e-jigsaw/eurorack/ember/primitives/jacks/pj301m-12.md

# PJ301M-12 (Thonkiconn)

Eurorack で de facto 標準の 3.5mm vertical mono switching jack。Mutable Instruments を含むほぼ全モジュールで採用。

## ピン

| Pin | Label / aliases | 役割 | X | Y |
|---|---|---|---:|---:|
| 1 | `TIP` | プラグ挿入時の信号 | 0 | −4.92 |
| 2 | `NORM_TIP` / `SWITCH` | プラグ未挿入時に TIP に内部結線される (normalled) | 0 | +3.38 |
| 3 | `SLEEVE` / `GND` | リターン | 0 | +6.48 |

座標は barrel 中心を原点、mm。

## フットプリント

- pad: Ø1.8 mm 円、drill: Ø1.6 mm (nebs/eurocad など de facto 慣用値)
- barrel 直下に Ø3 mm NPTH (datasheet 推奨)
- 本体 outline: 9.0 × 9.0 mm

## 機械仕様 (CMS-263 確定)

| 項目 | 値 |
|---|---|
| board-to-panel | 10.0 mm |
| bushing ねじ部 (= パネル板厚許容) | 4.5 mm |
| bushing ねじ | M6 × 0.75 |
| パネル穴推奨 | Ø6.3 mm (Mutable Links 実測) |

## 対応シンボル名

| CAD | 名称 |
|---|---|
| Mutable Instruments Eagle | `PJ301_THONKICONN6` |
| KiCad (標準ライブラリ近似) | `Connector_Audio:Jack_3.5mm_QingPu_WQP518WB-G_Vertical` |

## 出典

- Thonk datasheet: https://www.thonk.co.uk/wp-content/uploads/2014/02/Thonkiconn_Jack_Datasheet.pdf
- Thonk 商品ページ: https://www.thonk.co.uk/shop/thonkiconn/
- nebs/eurocad KiCad: https://github.com/nebs/eurocad/blob/master/Eurocad.pretty/PJ301M-12.kicad_mod
- Qingpu (元メーカー): http://qingpu-electronics.com/en/products/WQP-PJ301M-12-306.html
- firstpr.com.au 実測: https://www.firstpr.com.au/rwi/parts/3.5mm-sockets/

## 関連 Linear

- CMS-259 (この実装)
- CMS-263 (軸長検証、Done)
