e-jigsaw/eurorack/ember/__snapshots__/links-control.circuit-3d.snap.png

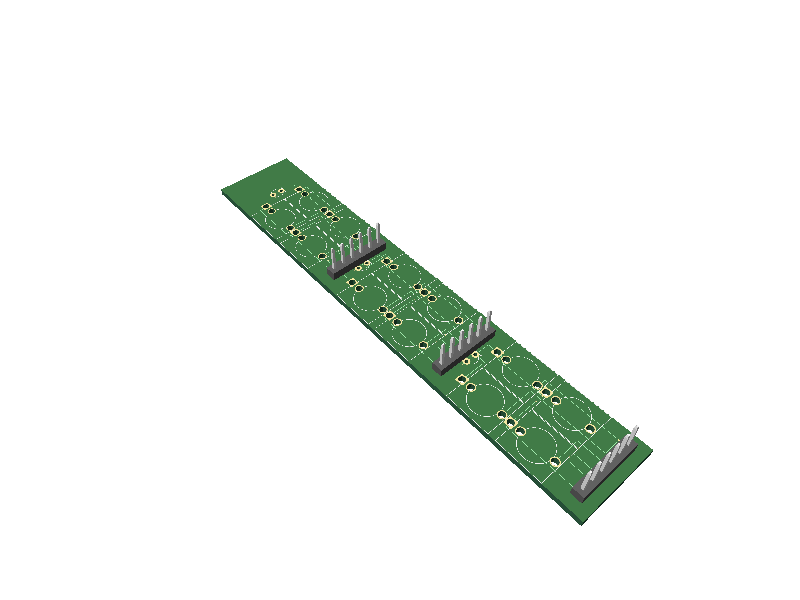
ember/__snapshots__/links-control.circuit-3d.snap.png
