e-jigsaw/eurorack/links/hardware_design/pcb/links_v40.9.brd

## EAGLE design links/hardware_design/pcb/links_v40.9.brd (2026-05-17)

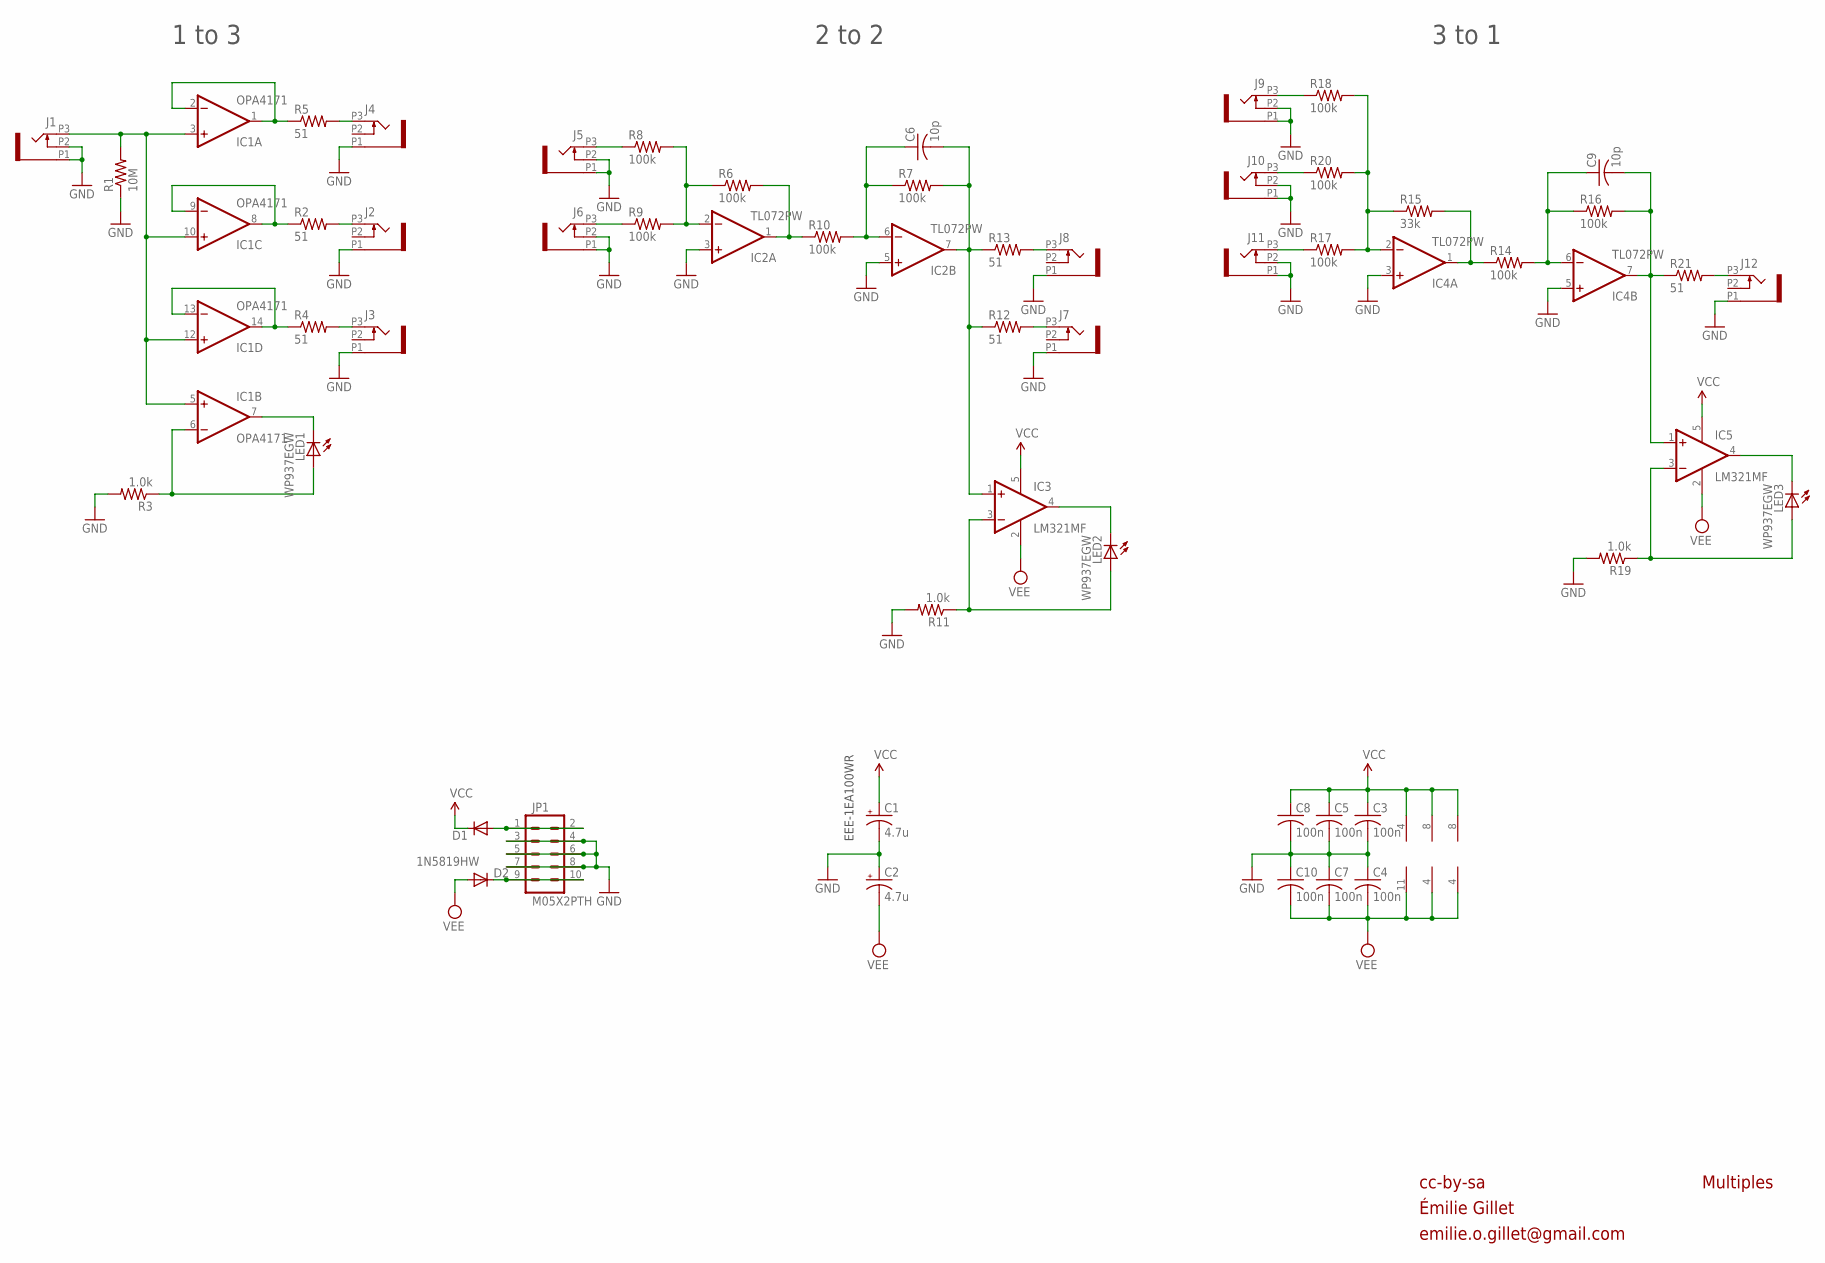
[picture p2: schematic links_v40.9.sch]

Parts:
C1, C2: 4.7u; PANASONIC_A
C3, C4, C5, C7, C8, C10: 100n; C0603
C6, C9: 10p; C0603
D1, D2: 1N5819HW; SOD123
IC1: OPA4171; TSSOP14
IC2, IC4: TL072PW; TSSOP8
IC3, IC5: LM321MF; SOT23-5
J1, J2, J3, J4, J5, J6, J7, J8, J9, J10, J11, J12: PJ301_THONKICONN6; WQP_PJ_301M6
JP1: M05X2PTH; AVR_ICSP
LED1, LED2, LED3: WP937EGW; LED3MM
R1: 10M; R0603
R2, R4, R5, R12, R13, R21: 51; R0603
R3, R11, R19: 1.0k; R0603
R6, R7, R8, R9, R10, R14, R16, R17, R18, R20: 100k; R0603
R15: 33k; R0603

Connections:
GND: C1.-, C2.+, C3.2, C4.1, C5.2, C7.1, C8.2, C10.1, IC2.3 (+IN), IC2.5 (+IN), IC4.3 (+IN), IC4.5 (+IN), J1.P1 (1), J1.P2 (2), J2.P1 (1), J3.P1 (1), J4.P1 (1), J5.P1 (1), J5.P2 (2), J6.P1 (1), J6.P2 (2), J7.P1 (1), J8.P1 (1), J9.P1 (1), J9.P2 (2), J10.P1 (1), J10.P2 (2), J11.P1 (1), J11.P2 (2), J12.P1 (1), JP1.3, JP1.4, JP1.5, JP1.6, JP1.7, JP1.8, R1.1, R3.2, R11.2, R19.2
unnamed: IC2.1 (OUT), R6.2, R10.1
unnamed: J11.P3 (3), R17.1
unnamed: IC1.1 (OUT), IC1.2 (-IN), R5.1
unnamed: IC1.8 (OUT), IC1.9 (-IN), R2.1
unnamed: IC1.13 (-IN), IC1.14 (OUT), R4.1
unnamed: D1.A, JP1.1, JP1.2
unnamed: IC1.3 (+IN), IC1.5 (+IN), IC1.10 (+IN), IC1.12 (+IN), J1.P3 (3), R1.2
unnamed: IC1.7 (OUT), LED1.K (C)
unnamed: J10.P3 (3), R20.1
unnamed: J6.P3 (3), R9.1
unnamed: J4.P3 (3), R5.2
unnamed: J2.P3 (3), R2.2
unnamed: J3.P3 (3), R4.2
unnamed: IC3.4 (OUT), LED2.K (C)
unnamed: J5.P3 (3), R8.1
unnamed: J7.P3 (3), R12.2
unnamed: J8.P3 (3), R13.2
unnamed: C9.2, IC4.7 (OUT), IC5.1 (+IN), R16.2, R21.1
unnamed: IC5.3 (-IN), LED3.A, R19.1
unnamed: D2.C, JP1.9, JP1.10
unnamed: IC1.6 (-IN), LED1.A, R3.1
unnamed: J9.P3 (3), R18.1
unnamed: J12.P3 (3), R21.2
unnamed: IC4.2 (-IN), R15.1, R17.2, R18.2, R20.2
unnamed: IC4.1 (OUT), R14.1, R15.2
unnamed: C6.2, IC2.7 (OUT), IC3.1 (+IN), R7.2, R12.1, R13.1
unnamed: C9.1, IC4.6 (-IN), R14.2, R16.1
unnamed: IC3.3 (-IN), LED2.A, R11.1
unnamed: IC5.4 (OUT), LED3.K (C)
unnamed: IC2.2 (-IN), R6.1, R8.2, R9.2
unnamed: C6.1, IC2.6 (-IN), R7.1, R10.2
VCC: C1.+, C3.1, C5.1, C8.1, D1.C, IC1.4 (V+), IC2.8 (V+), IC3.5 (V+), IC4.8 (V+), IC5.5 (V+)
VEE: C2.-, C4.2, C7.2, C10.2, D2.A, IC1.11 (V-), IC2.4 (V-), IC3.2 (V-), IC4.4 (V-), IC5.2 (V-)

Notes on the sheet:
cc-by-sa
Multiples
1 to 3
2 to 2
3 to 1
EEE-1EA100WR
Émilie Gillet
emilie.o.gillet@gmail.com

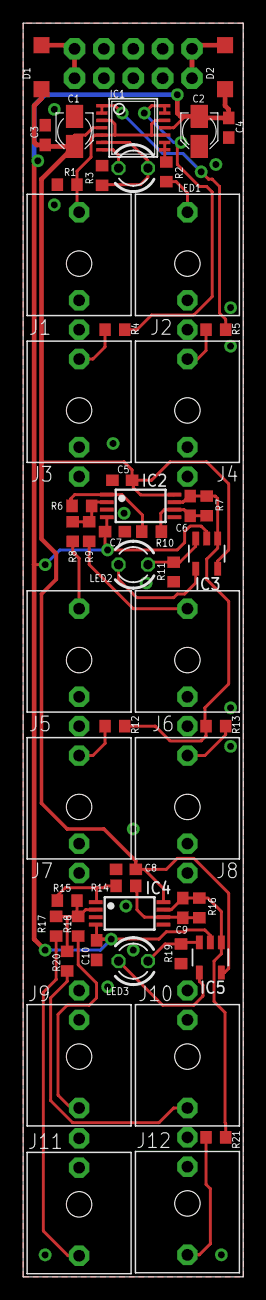
[picture p3: board links_v40.9.brd from above]

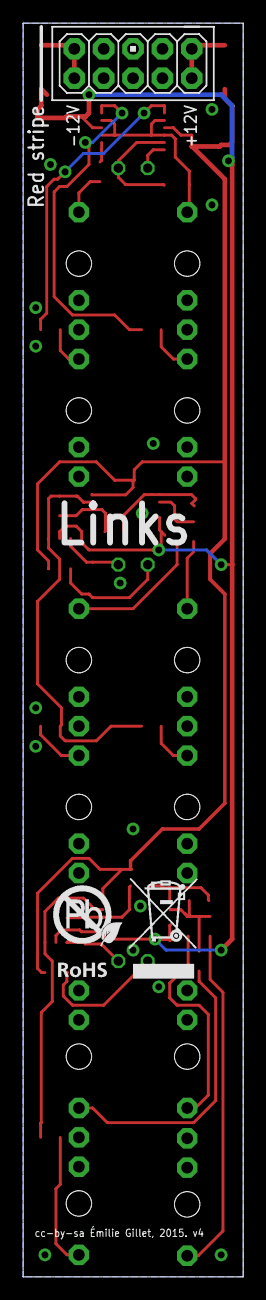
[picture p4: board links_v40.9.brd from below]

Board: 2 copper layers, 19.0 x 108.4 mm, 55 parts (2 on the bottom side), 34 nets.

Other parts of the board:
U$2: ROHS
