e-jigsaw/eurorack/(commit log)

2026-04-14 Added Eagle to KiCad migration investigation notes
2026-05-17 Archived Eagle to KiCad migration investigation and parser
    Stopped pursuing the Eagle-to-KiCad routes (Autodesk-based conversion
    and PDF reconstruction) in favor of evaluating the Autodesk MCP
    integration. Moved the migration notes and the eagle_parser tooling
    under archive/ for reference.
2026-05-17 Links: JLCPCB assembly BOM substitution and Eagle v40.9 reformat
    Picked LCSC-stocked alternatives for parts unavailable on JLCPCB and
    documented the rationale alongside an Eagle script that swaps the
    ATTRIBUTE/VALUE fields. Re-saved the Eagle files as v40.9 in the
    newer format so Autodesk Fusion's KiCad import path becomes usable.
    [links_v40.9.brd, links_v40.9.sch]
2026-05-17 Added ember tscircuit project with PJ301M-12 primitive
    Bootstrapped a tscircuit project under ember/ to incrementally
    re-implement Mutable Instruments modules. First reusable primitive
    is the PJ301M-12 (Thonkiconn) 3.5mm vertical jack footprint,
    verified via tsci build and snapshot.
2026-05-17 ember: Eurorack power input (Doepfer header + reverse protection)
    Adds the Doepfer 2x5 box header pinout/footprint (67996-410HLF), plus
    an EurorackPowerInput subcircuit wrapping Mutable's standard
    series-Schottky reverse protection (1N5819HW x 2) with 47uF/25V bulk
    caps. Verified via tsci build and snapshot.
2026-05-17 ember: EurorackPCB primitive (minimal board wrapper)
    Adds the EurorackPCB component as a thin <board> wrapper:
    auto-sized from children (PCB is sized to fit placed parts),
    1.6mm default thickness, no mounting holes (the PCB is secured
    to the front panel via the jack bushing nuts, following the
    Mutable/Eurorack convention). Also exports HP_MM (5.08, nominal
    HP) and PANEL_MM_PER_HP (5.0, Doepfer panel convention).
2026-05-17 ember: drop reverse-polarity protection from EurorackPowerInput
    Doepfer box header notch + keyed IDC ribbon (Tiptop / Make Noise /
    Erica / Doepfer 純正 etc.) physically prevent reverse insertion, so
    the series Schottky diodes are redundant. Aligns with MiniOSC v2.1
    and the DIY convention. Bulk caps reduced to 22uF/25V 0805 for
    realistic X7R capacity, and the decoupling pattern (one 100nF per
    IC rail via <capacitor decouplingFor>) is documented in the README.
2026-05-17 ember: Links module v1 (BM/US/SM + IC rotation + jack silk on bottom)
    Adds the Links module composition (1→3 BufferedMult, 2:2 UtilitySum,
    3→1 SumMixer3to1) plus chip primitives (OPA4171, TL072, LM321) and
    WP937EGW LED. ICs are vertical (pcbRotation=90) to fit the 4HP width;
    component positions iterated via dev UI manual edits. Jack silkscreen
    is now on the bottom layer so it doesn't compete with the panel face.
    Captured at a checkpoint before stripping component positions to let
    the autorouter retry placement.
2026-05-20 ember: Links blocks decomposed into reusable units with port interfaces
    Each block (BM/US/SM) becomes a directory of small subs that expose
    external IO via `<subcircuit|group showAsSchematicBox connections={{...}}>`,
    so the outer block can wire port-to-port (`.amp > .OUT_B` → `.buf > .IN`)
    without touching internal component names.
    Routing knobs (layers=2, sequential-trace autorouter, 0.15mm/0.12mm trace
    widths, 0.08mm pad clearance) are pinned on `EurorackPCB`. TL072/OPA4171
    footprints switched to explicit 0.65mm pitch. WP937EGW now forwards the
    `connections` prop. `preview.tsx` per block wraps the sub in a board so
    each can be opened standalone in the dev viewer.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
2026-07-11 ember: Links interconnect constants + 1x6 board-to-board header primitive
2026-07-11 ember: make typecheck a real gate (allowImportingTsExtensions + drop unsupported key prop)
    Claude-Session: https://claude.ai/code/session_0183w9WTo3Q2T6sPvC4KGmZX
2026-07-11 ember: BufferedMult split into control/main board halves
2026-07-11 ember: bump tscircuit 0.0.1766 -> 0.0.2046 (+ matching capacity-autorouter)
    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
2026-07-11 ember: UtilitySum2x2 split into control/main board halves
2026-07-11 ember: UtilitySum main board GND island rejoined to ground net
2026-07-11 ember: SumMixer3to1 split into control/main board halves
2026-07-11 ember: Links v2 two-board stack (control + main, 4HP)
2026-07-11 ember: interconnect mating check for the Links two-board stack
2026-07-11 ember: final review fixes (README, check wiring, BM supply traces, consistency)
2026-07-11 ember: encode header gender in footprint string so 3D renders sockets
    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
2026-07-11 ember: Doepfer power header mounts on the main board's rear face
    In the panel->control->main stack the component side faces the panel, so
    the shrouded power header must sit on the bottom (rear) face for the
    ribbon to plug in. layer="bottom" flips the part as a unit (holes, body,
    key, pin1), keeping the keyed ribbon's red stripe on the VEE column; the
    RED silk marker moves to the bottom silk on the mirrored (+x) side and
    the bulk caps swap sides to follow their rails.
    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
2026-07-11 ember: control-board headers rear-mounted; mating model corrected to shared frame
    Both boards face the panel with their component side, so their XY frames
    coincide and mating is direct (x, y) equality — not a board flip. The
    control board's male headers therefore mount on its rear face
    (layer="bottom"); the part-level side-flip mirrors the label-to-hole
    mapping, which is what the main side's mainPinOrder reversal mates with.
    Previously the headers sat on the panel-side face: pins would have pointed
    at the panel, and label positions would have crossed IN onto GND when
    plugged. check-interconnect now asserts direct set equality in the shared
    frame (it fails if either the side-flip or the rev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
2026-07-11 ember: LED assembly silk moves to the solder side with a cathode bar
    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
2026-07-11 ember: silkscreen sits on each part's component face (jacks back to top)
    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
2026-07-11 ember: add 3d snapshots for the two Links boards
    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
2026-07-11 ember: fab-limits routing constraints (JLCPCB 2-layer minimums)
    Traces (0.10mm), vias (0.2mm hole/0.3mm pad), and different-net spacing
    (down to 0.125mm) in the routed Links copper all violate JLCPCB's 2-layer
    minimums. Root cause: a subcircuit's minTraceWidth/minVia* props are not
    inherited from the enclosing <board>, and every block root here is a
    <subcircuit> — so the board's settings alone never reached the copper.
    Via sizing under the sequential-trace router has a second, separate gap:
    it reads pcbStyle.viaHoleDiameter/viaPadDiameter, not
    minViaHoleDiameter/minViaPadDiameter (that pair only feeds the unused
    whole-board async autorouter's via path).
    primitives/pcb/fab-limits.ts centra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
2026-07-11 ember: DFM gate script (trace width / via size / spacing)
    scripts/check-dfm.ts reads a built circuit.json and asserts, per JLCPCB's
    2-layer minimums (imported from primitives/pcb/fab-limits.ts): every
    pcb_trace wire segment width >= 0.127mm, every pcb_via hole/pad diameter
    >= 0.3mm/0.45mm, and different-net trace spacing >= 0.127mm. Net identity
    for the spacing check is derived from source_trace.subcircuit_connectivity_map_key
    (keyed via pcb_trace.source_trace_id), then further unioned across traces
    that share a physical pcb_port_id at a route endpoint — without that
    union, a block's local net and the board-level net it stitches into read
    as "different nets" at their shared pad, producing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
2026-07-11 ember: DFM gate hardening (index-keyed net union, pad-edge clearance constant)
    check-dfm.ts keyed its union-find (and its keyless-trace net fallback) by
    pcb_trace_id — but tscircuit can emit duplicate pcb_trace_ids (e.g.
    several "pcb_trace_for___net_trace_tmp"; see the warning comment in
    check-interconnect.ts). Two different-net traces sharing a colliding id
    would silently merge into one net and skip the spacing check, false-PASSing
    a real violation (verified with a mutated circuit.json: two same-id keyless
    traces 0.05mm apart — the id-keyed version PASSes, the index-keyed one
    FAILs). Union-find nodes are now pcb_trace array indices.
    Also moves the board's hardcoded minTraceToPadEdgeCle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
2026-07-11 ember: power header gets a JLCPCB-assemblable part (DC3-2.54-10PAS, C2977596)
    The interconnect headers stay hand-soldered; the power shroud goes on the
    PCBA BOM. Datasheet-verified drop-in for the Amphenol 67996-410HLF: same
    2.54mm grid and long-side key; 20.3mm body sits flush on the 20mm board.
    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
2026-07-11 ember: interconnect headers get JLCPCB-assemblable parts per gender
    male = BOOMELE 2.54-1x6P (C37208), female = XFCN PM254V-11-06-H85
    (C2832269), both datasheet-verified against the pinrow footprint. The
    mated stack is male body 2.5mm + female height 8.5mm = 11.0mm board gap
    (docs previously said 8.5mm); the male's 6.0mm mating pin fully inserts.
    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
2026-07-12 ember: JLCPCB fab export pipeline (unique refdes BOM/CPL + LCSC parts map)
2026-07-12 ember: rail-safe board outline (19 x 108.4, matches real Links envelope)
2026-07-12 ember: board id silkscreen (Nok Audio / Links v0.1 / JLC order-number placeholder)
    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
2026-07-12 ember: KiCad panelization pipeline (verified-copper copy + edge rails)
2026-07-12 ember: panels ride top/bottom rails; power header lowered for tab clearance
2026-10-23 chore(ember): checkpoint links decoupling work for remote backup
    Preserve ongoing routing, decoupling checks and component selection separately from the single-board prototype. No new functional verification was performed for this checkpoint.
2026-10-24 fix(ember): resolve Links diodes and 4.7uF bulk caps to LCSC parts
