e-jigsaw/eurorack/(notices)

Notices in the files:
links/hardware_design/pcb/links_v40.9.brd:
cc-by-sa Émilie Gillet, 2015. v4
